DevenMarrero/8-Bit_CPU/README.md

# 8-Bit_CPU

This is a repository to hold all the tools I used to builld my advanced 8 bit computer as well as its documentation which is a work in progress.

APC_0032 (2)
