DevenMarrero/8-Bit_CPU/schematics/PDF/Clock.pdf

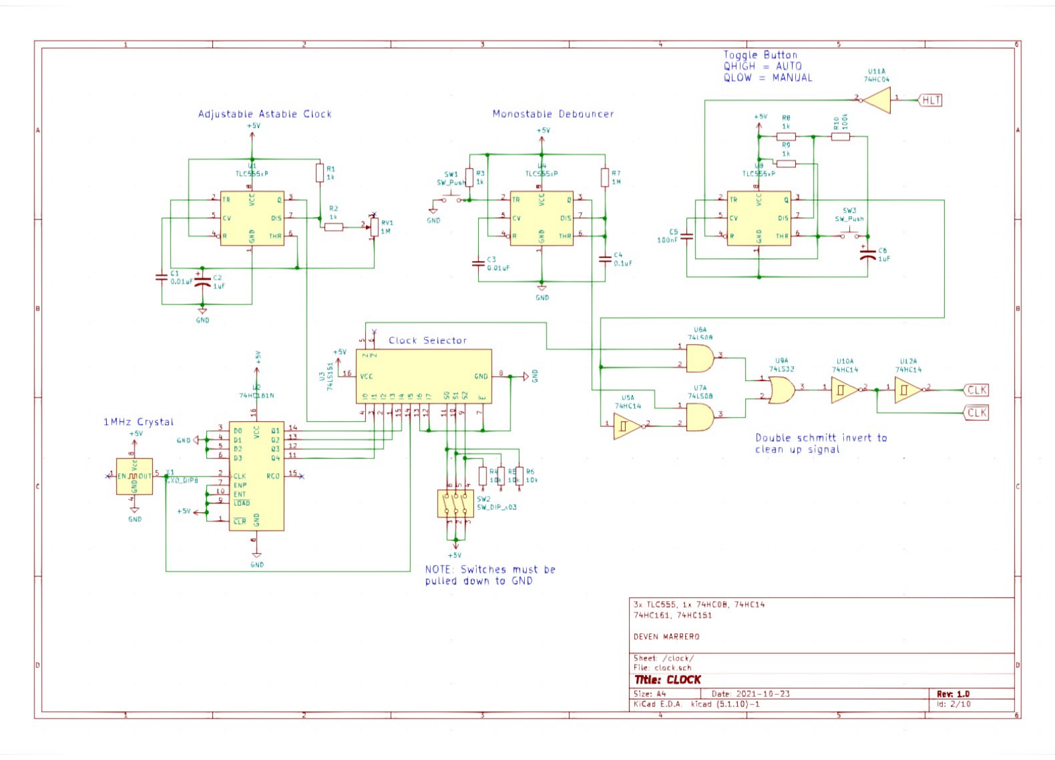
[picture p1: page 1]
