DevenMarrero/8-Bit_CPU/schematics/PDF/Control Logic.pdf

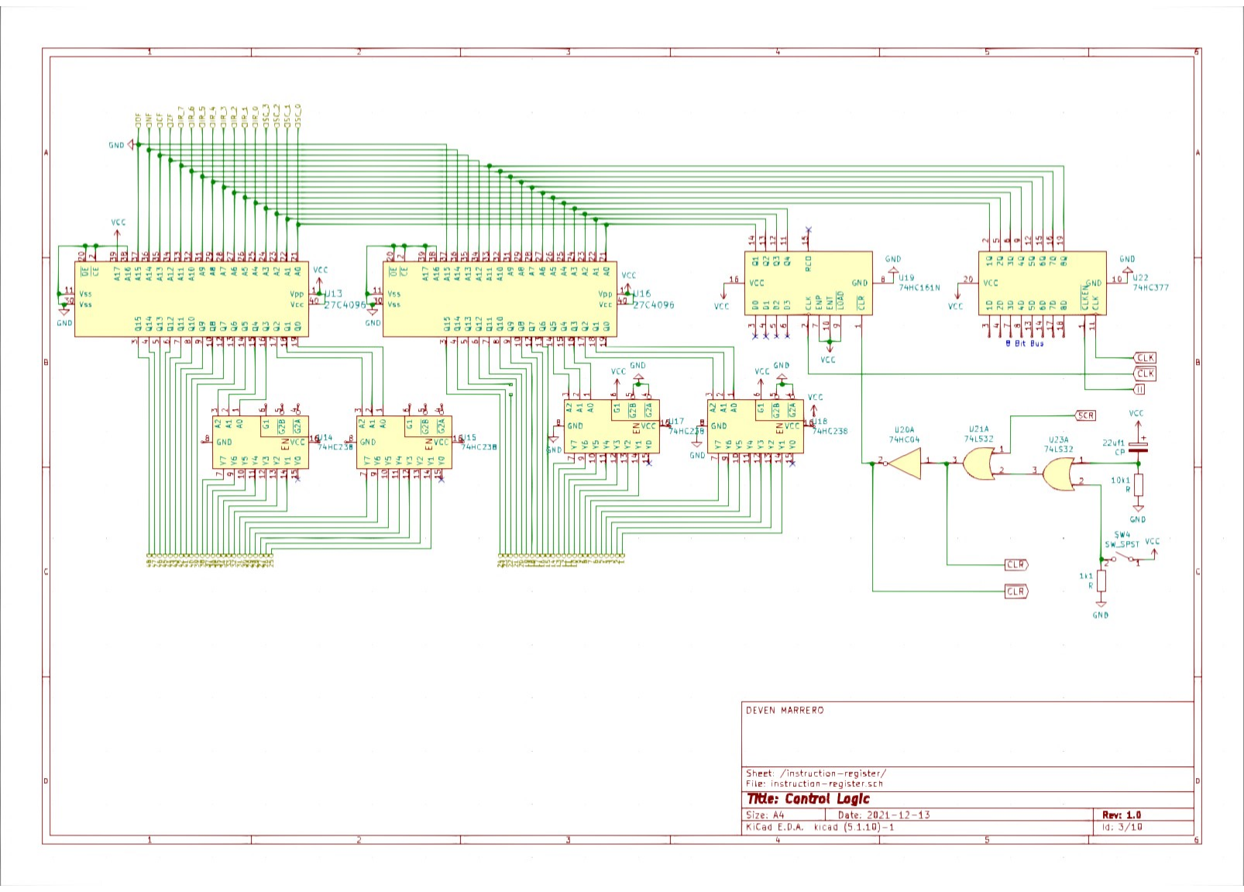
[picture p2: page 1]
