DevenMarrero/8-Bit_CPU/schematics/PDF/General Registers.pdf

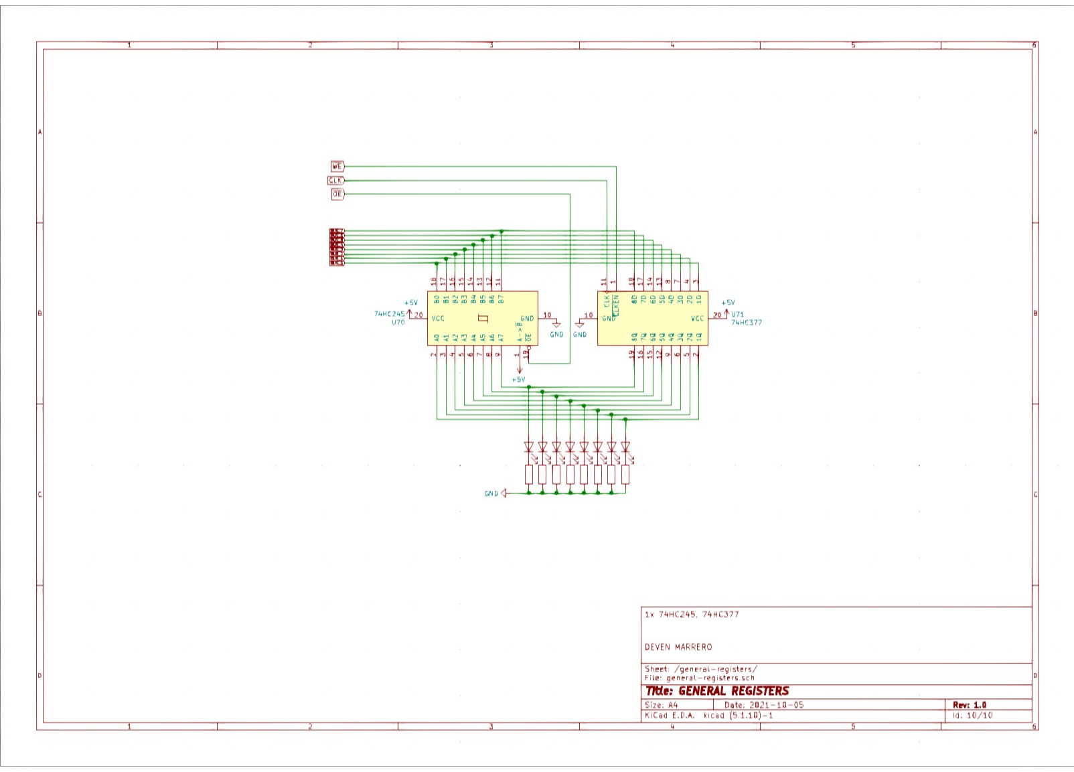
[picture p3: page 1]
