DevenMarrero/8-Bit_CPU/schematics/PDF/Memory Address Register.pdf

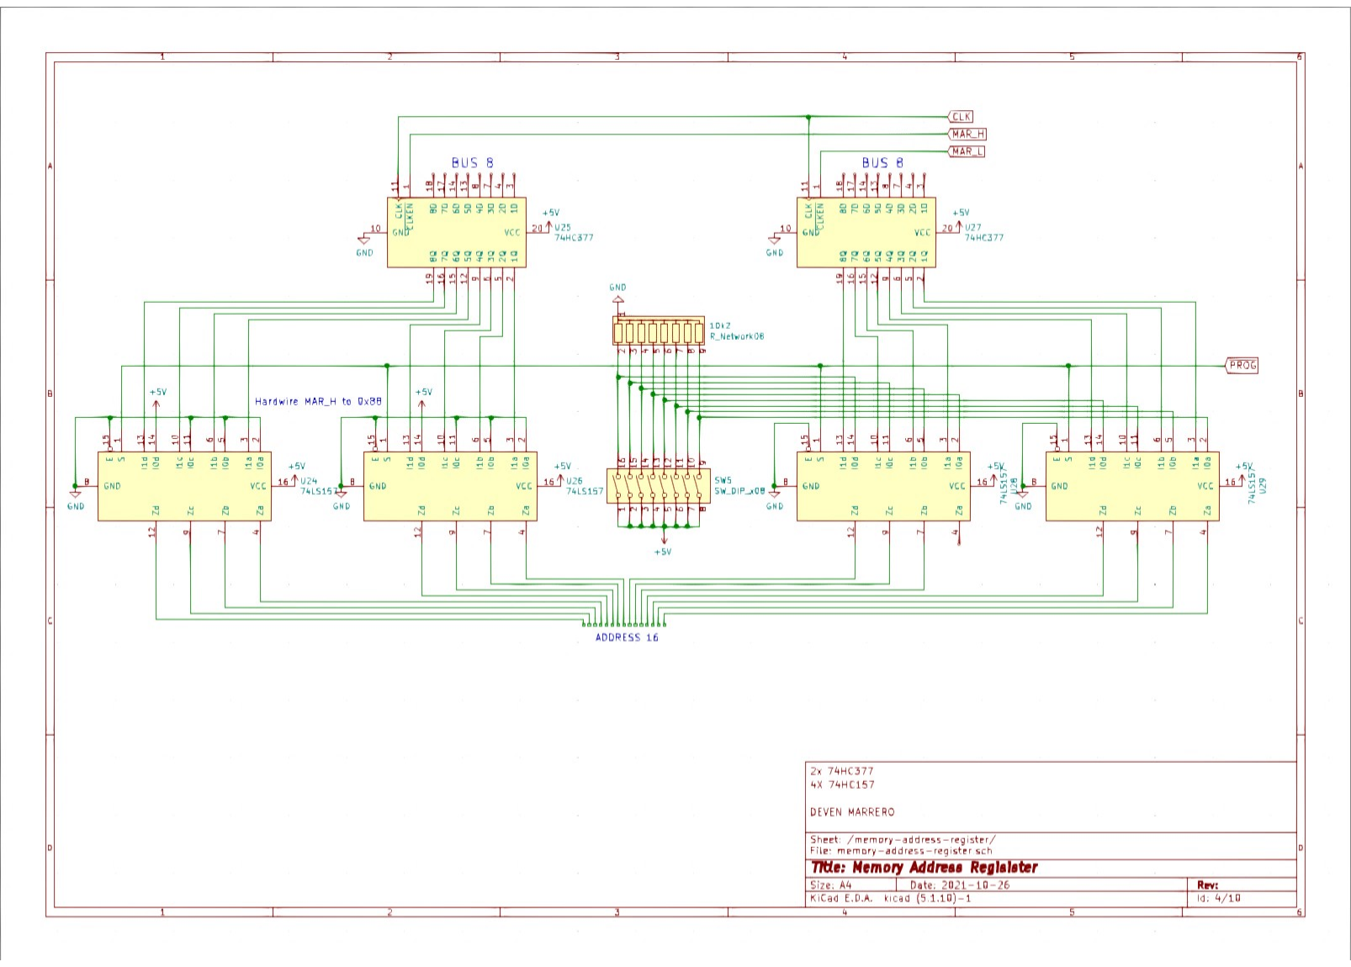
[picture p4: page 1]
