DevenMarrero/8-Bit_CPU/schematics/PDF/Memory Map Controller.pdf

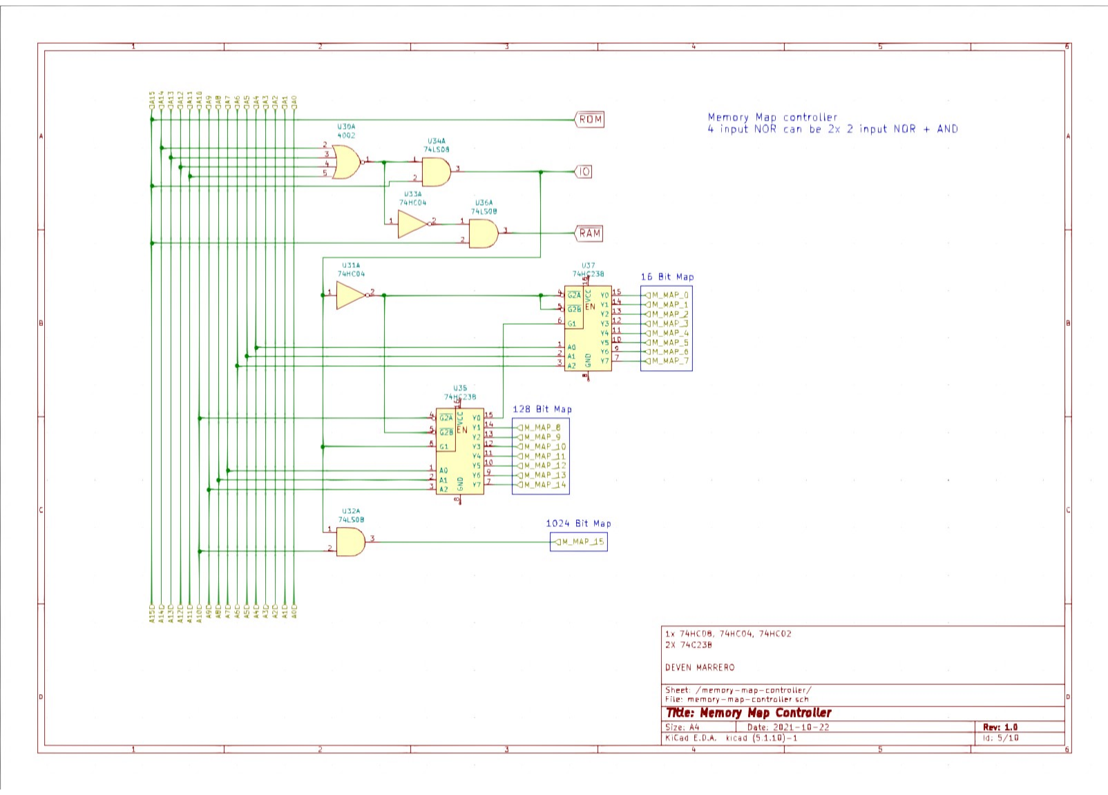
[picture p5: page 1]
