DevenMarrero/8-Bit_CPU/schematics/PDF/Output Hex.pdf

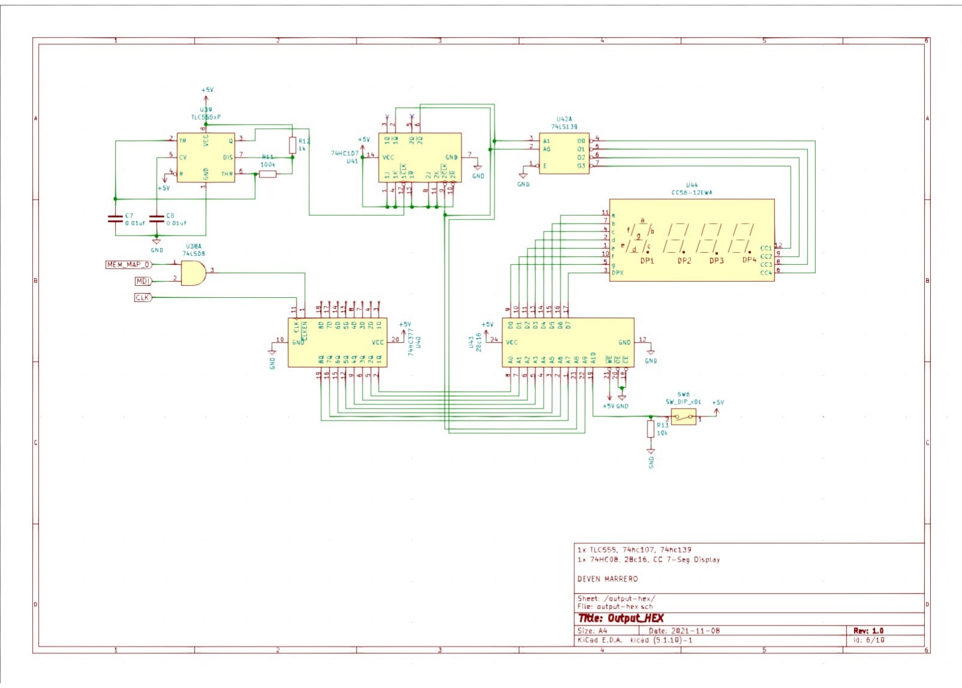
[picture p6: page 1]
