DevenMarrero/8-Bit_CPU/schematics/PDF/Program Counter.pdf

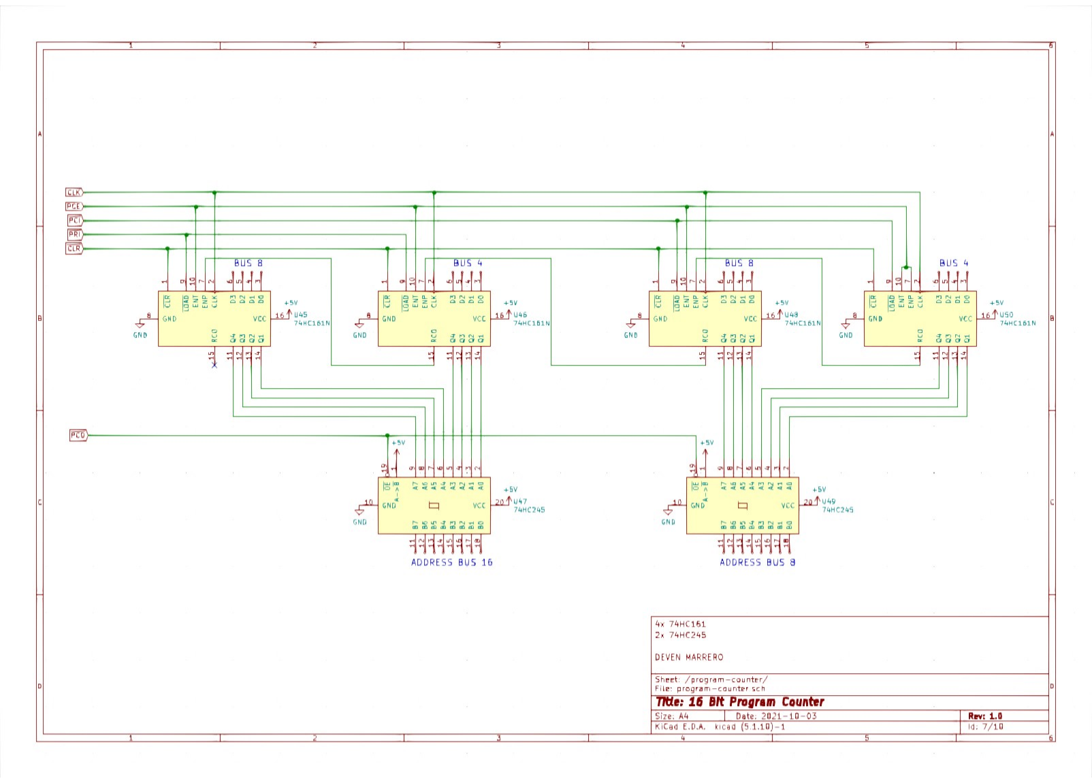
[picture p7: page 1]
