DevenMarrero/8-Bit_CPU/schematics/PDF/Ram Rom.pdf

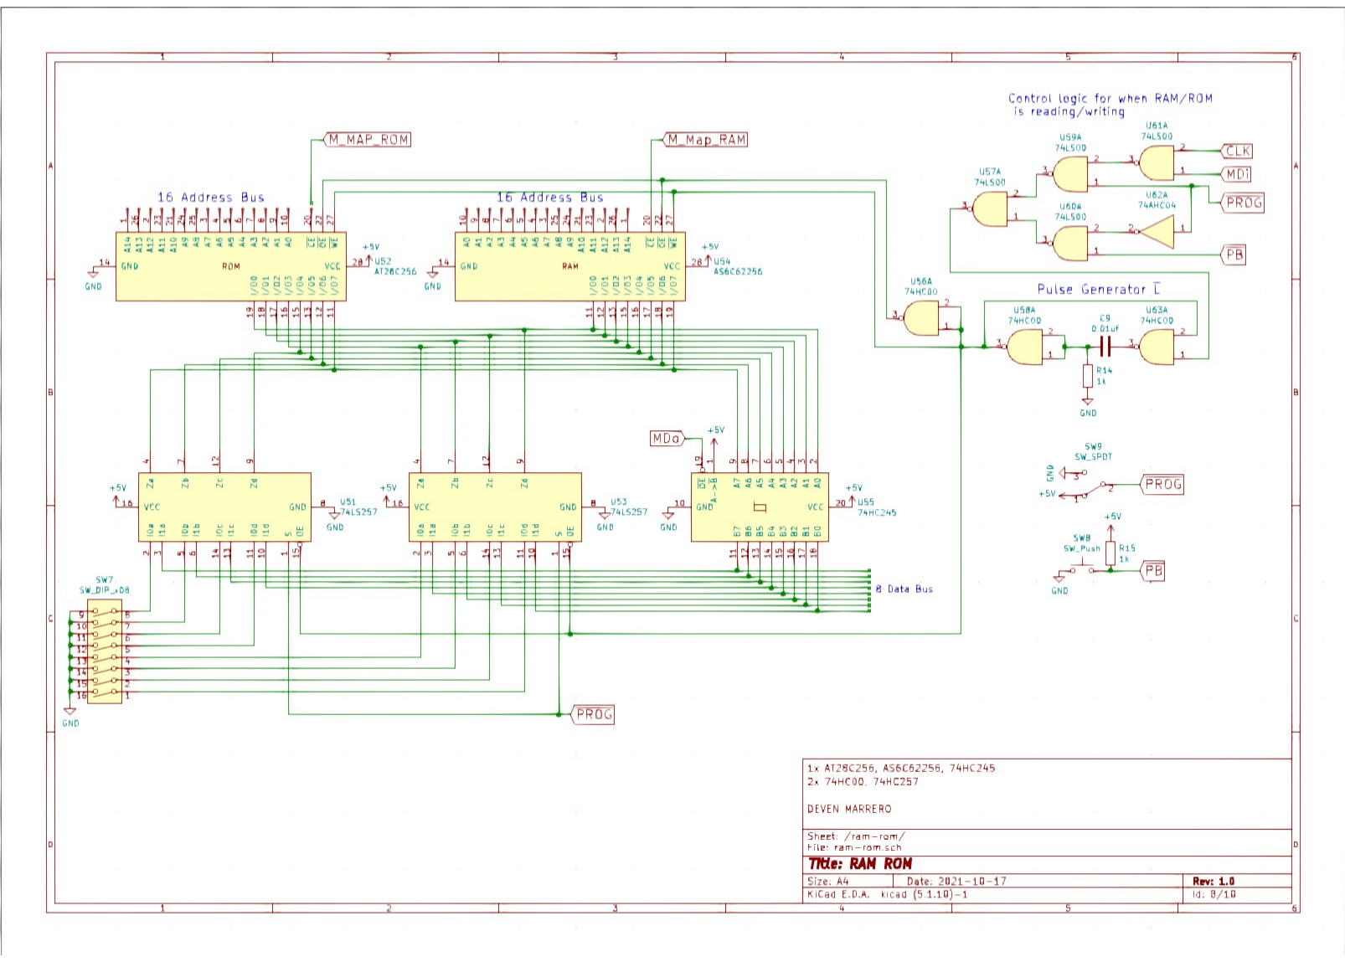
[picture p8: page 1]
