DevenMarrero/8-Bit_CPU/schematics/PDF/Stack Pointer.pdf

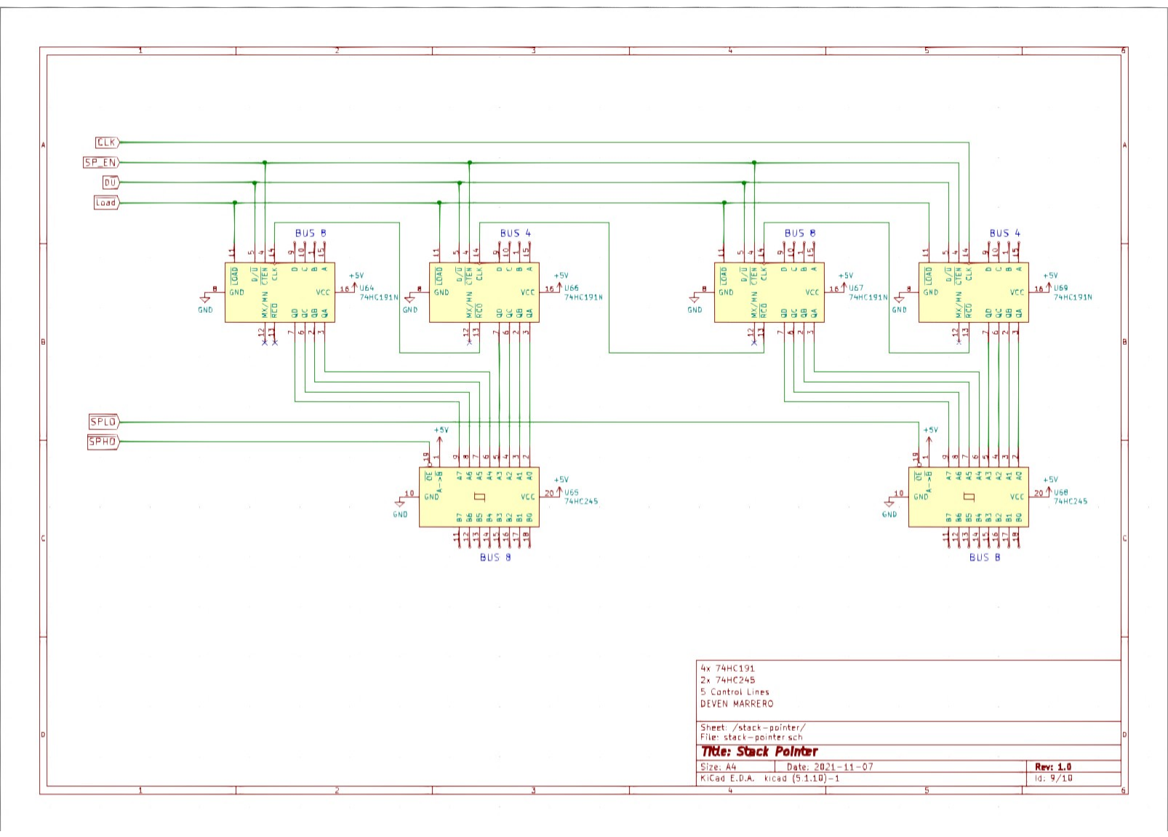
[picture p9: page 1]
