DevenMarrero/8-Bit_CPU/schematics/KiCad/clock.sch

## KiCad design schematics/KiCad/clock.sch (2022-02-21)

Schematic: clock.sch

Parts:
C1, C3: 0.01uF
C2, C6: 1uF
C4: 0.1uF
C5: 100nF
R1, R2, R3, R8, R9: 1k
R4, R5, R6: 10k
R7: 1M
R10: 100k
RV1: 1M
SW1, SW3: SW_Push
SW2: SW_DIP_x03
U1, U4, U8: TLC555xP; DIP-8_W7.62mm
U2: 74HC161N
U3: 74LS151
U5, U10, U12: 74HC14
U6, U7: 74LS08
U9: 74LS32
U11: 74HC04
X1: CXO_DIP8; Oscillator_DIP-8

Notes on the sheet:
Adjustable Astable Clock
Monostable Debouncer
Toggle Button QHIGH = AUTO QLOW = MANUAL
NOTE: Switches must be pulled down to GND
Clock Selector
1MHz Crystal
Double schmitt invert to clean up signal
