DevenMarrero/8-Bit_CPU/schematics/KiCad/general-registers.sch

## KiCad design schematics/KiCad/general-registers.sch (2022-02-21)

Schematic: general-registers.sch

Parts:
D1, D2, D3, D4, D5, D6, D7, D8: LED
R16, R17, R18, R19, R20, R21, R22, R23: R
U70: 74HC245
U71: 74HC377
