DevenMarrero/8-Bit_CPU/schematics/KiCad/instruction-register.sch

## KiCad design schematics/KiCad/instruction-register.sch (2022-02-21)

Schematic: instruction-register.sch

Parts:
1k1, 10k1: R
22uf1: CP
SW4: SW_SPST
U13, U16: 27C4096
U14, U15, U17, U18: 74HC238
U19: 74HC161N
U20: 74HC04
U21, U23: 74LS32
U22: 74HC377

Notes on the sheet:
8 Bit Bus
