DevenMarrero/8-Bit_CPU/schematics/KiCad/memory-address-register.sch

## KiCad design schematics/KiCad/memory-address-register.sch (2022-02-21)

Schematic: memory-address-register.sch

Parts:
10k2: R_Network08; R_Array_SIP9
SW5: SW_DIP_x08
U24, U26, U28, U29: 74LS157
U25, U27: 74HC377

Notes on the sheet:
BUS 8
ADDRESS 16
Hardwire MAR_H to 0x88
