DevenMarrero/8-Bit_CPU/schematics/KiCad/memory-map-controller.sch

## KiCad design schematics/KiCad/memory-map-controller.sch (2022-02-21)

Schematic: memory-map-controller.sch

Parts:
U30: 4002
U31, U33: 74HC04
U32, U34, U36: 74LS08
U35, U37: 74HC238

Notes on the sheet:
16 Bit Map
128 Bit Map
1024 Bit Map
Memory Map controller 4 input NOR can be 2x 2 input NOR + AND
