DevenMarrero/8-Bit_CPU/schematics/KiCad/output-hex.sch

## KiCad design schematics/KiCad/output-hex.sch (2022-02-21)

Schematic: output-hex.sch

Parts:
C7, C8: 0.01uf
R11: 100k
R12: 1k
R13: 10k
SW6: SW_DIP_x01
U38: 74LS08
U39: TLC555xP; DIP-8_W7.62mm
U40: 74HC377
U41: 74HC107
U42: 74LS139
U43: 28c16
U44: CC56-12EWA; CA56-12EWA
