DevenMarrero/8-Bit_CPU/schematics/KiCad/program-counter.sch

## KiCad design schematics/KiCad/program-counter.sch (2022-02-21)

Schematic: program-counter.sch

Parts:
U45, U46, U48, U50: 74HC161N
U47, U49: 74HC245

Notes on the sheet:
BUS 4
BUS 8
ADDRESS BUS 8
ADDRESS BUS 16
