DevenMarrero/8-Bit_CPU/schematics/KiCad/ram-rom.sch

## KiCad design schematics/KiCad/ram-rom.sch (2022-02-21)

Schematic: ram-rom.sch

Parts:
C9: 0.01uf
R14, R15: 1k
SW7: SW_DIP_x08
SW8: SW_Push
SW9: SW_SPDT
U51, U53: 74LS257
U52: AT28C256
U54: AS6C62256
U55: 74HC245
U56, U58, U63: 74HC00
U57, U59, U60, U61: 74LS00
U62: 74AHC04

Notes on the sheet:
16 Address Bus
8 Data Bus
Control logic for when RAM/ROM is reading/writing
Pulse Generator ~L
