DevenMarrero/8-Bit_CPU/schematics/KiCad/stack-pointer.sch

## KiCad design schematics/KiCad/stack-pointer.sch (2022-02-21)

Schematic: stack-pointer.sch

Parts:
U64, U66, U67, U69: 74HC191N
U65, U68: 74HC245

Notes on the sheet:
BUS 4
BUS 8
BUS 8
