DevenMarrero/8-Bit_CPU/arduino-programmer/sendFile.py

import time
import argparse
import serial # pip install pyserial


def connect_arduino(port, baudrate) -> serial.Serial:
	"""Connect to the arduino over serial"""
	try:
		# connect to the arduino and allow time to stabilize 
		arduino = serial.Serial(port=port, baudrate=baudrate, timeout=0.1)
		time.sleep(2)
		return arduino
	except serial.serialutil.SerialException:
		print(f"ERROR: Could not find Arduino on {port}")
		exit()


def write_read(byte) -> str.encode:
	"""Sends byte to arduino and waits for a response"""
	arduino.write(bytes(byte, 'utf-8'))
	data = b''
	while data == b'':
		data = arduino.readline()
	time.sleep(0.001)
	return data


def bytes_from_file(filename):
	"""Generator to iterate over all bytes in a binary file"""
	with open(filename, "rb") as f:
		while True:
			# read entire file
			chunk = f.read(1)
			if chunk:
				for byte in chunk:
					yield byte
			else:
				break

if __name__ == "__main__":
    # command line argument parser
	parser = argparse.ArgumentParser(description="Send a .bin file to an Arduino.")
	parser.add_argument("file", help="file to send to arduino")
	parser.add_argument("port", help="port to connect to arduino. ie. COM4")
	parser.add_argument("-b", "--baudrate", type=int, default=115200,
						help="serial baudrate of arduino")
	args = parser.parse_args()
	file = args.file
	port = args.port
	baudrate = args.baudrate
	
	print("Initializing Connection...")
	arduino = connect_arduino(port, baudrate)
	print("Connection successful")

	print("Programming EEPROM")
	write_read('<') # arduino start transfer signal

	for byte in bytes_from_file(file):
		#print("sent:", byte)
		response = write_read(str(byte) + ';')
		#print("Recieved:", response.decode().replace("\n", ""))
	
	write_read('>') # arduino end transfer signal
	print("Finished Programming")
