DevenMarrero/8-Bit_CPU/(commit log)

2021-12-29 Fixed delay and added 200hz clock to pin A1
    [onboard_EEPROM_programmer.ino]
2022-02-19 Reformatted Repository Structure
    [8-bit-cpu-schematics.sch, clock.sch, general-registers.sch, instruction-register.sch, memory-address-register.sch, memory-map-controller.sch, output-hex.sch, program-counter.sch]
2022-02-20 Merged Schematics into project
    [8-bit-cpu-schematics.sch, clock.sch, general-registers.sch, instruction-register.sch, memory-address-register.sch, memory-map-controller.sch, output-hex.sch, program-counter.sch]
2022-02-20 added onboard Arduino programmer README.md
2022-02-20 Added info to main schematic
    [8-bit-cpu-schematics.sch, output-hex.sch]
2022-02-21 Added PDF Schematics
2022-02-21 Annotated Parts
    [clock.sch, general-registers.sch, instruction-register.sch, memory-address-register.sch, memory-map-controller.sch, output-hex.sch, program-counter.sch, ram-rom.sch]
2022-06-22 Replaced redundant if statement
    [arduino-programmer.ino]
